MetaKor/MKV-Boards/Boards/IMD+IMD_Latch/IMD_LATCH/IMD_LATCH.kicad_pcb

## KiCad design Boards/IMD+IMD_Latch/IMD_LATCH/IMD_LATCH.kicad_pcb (2020-12-04)

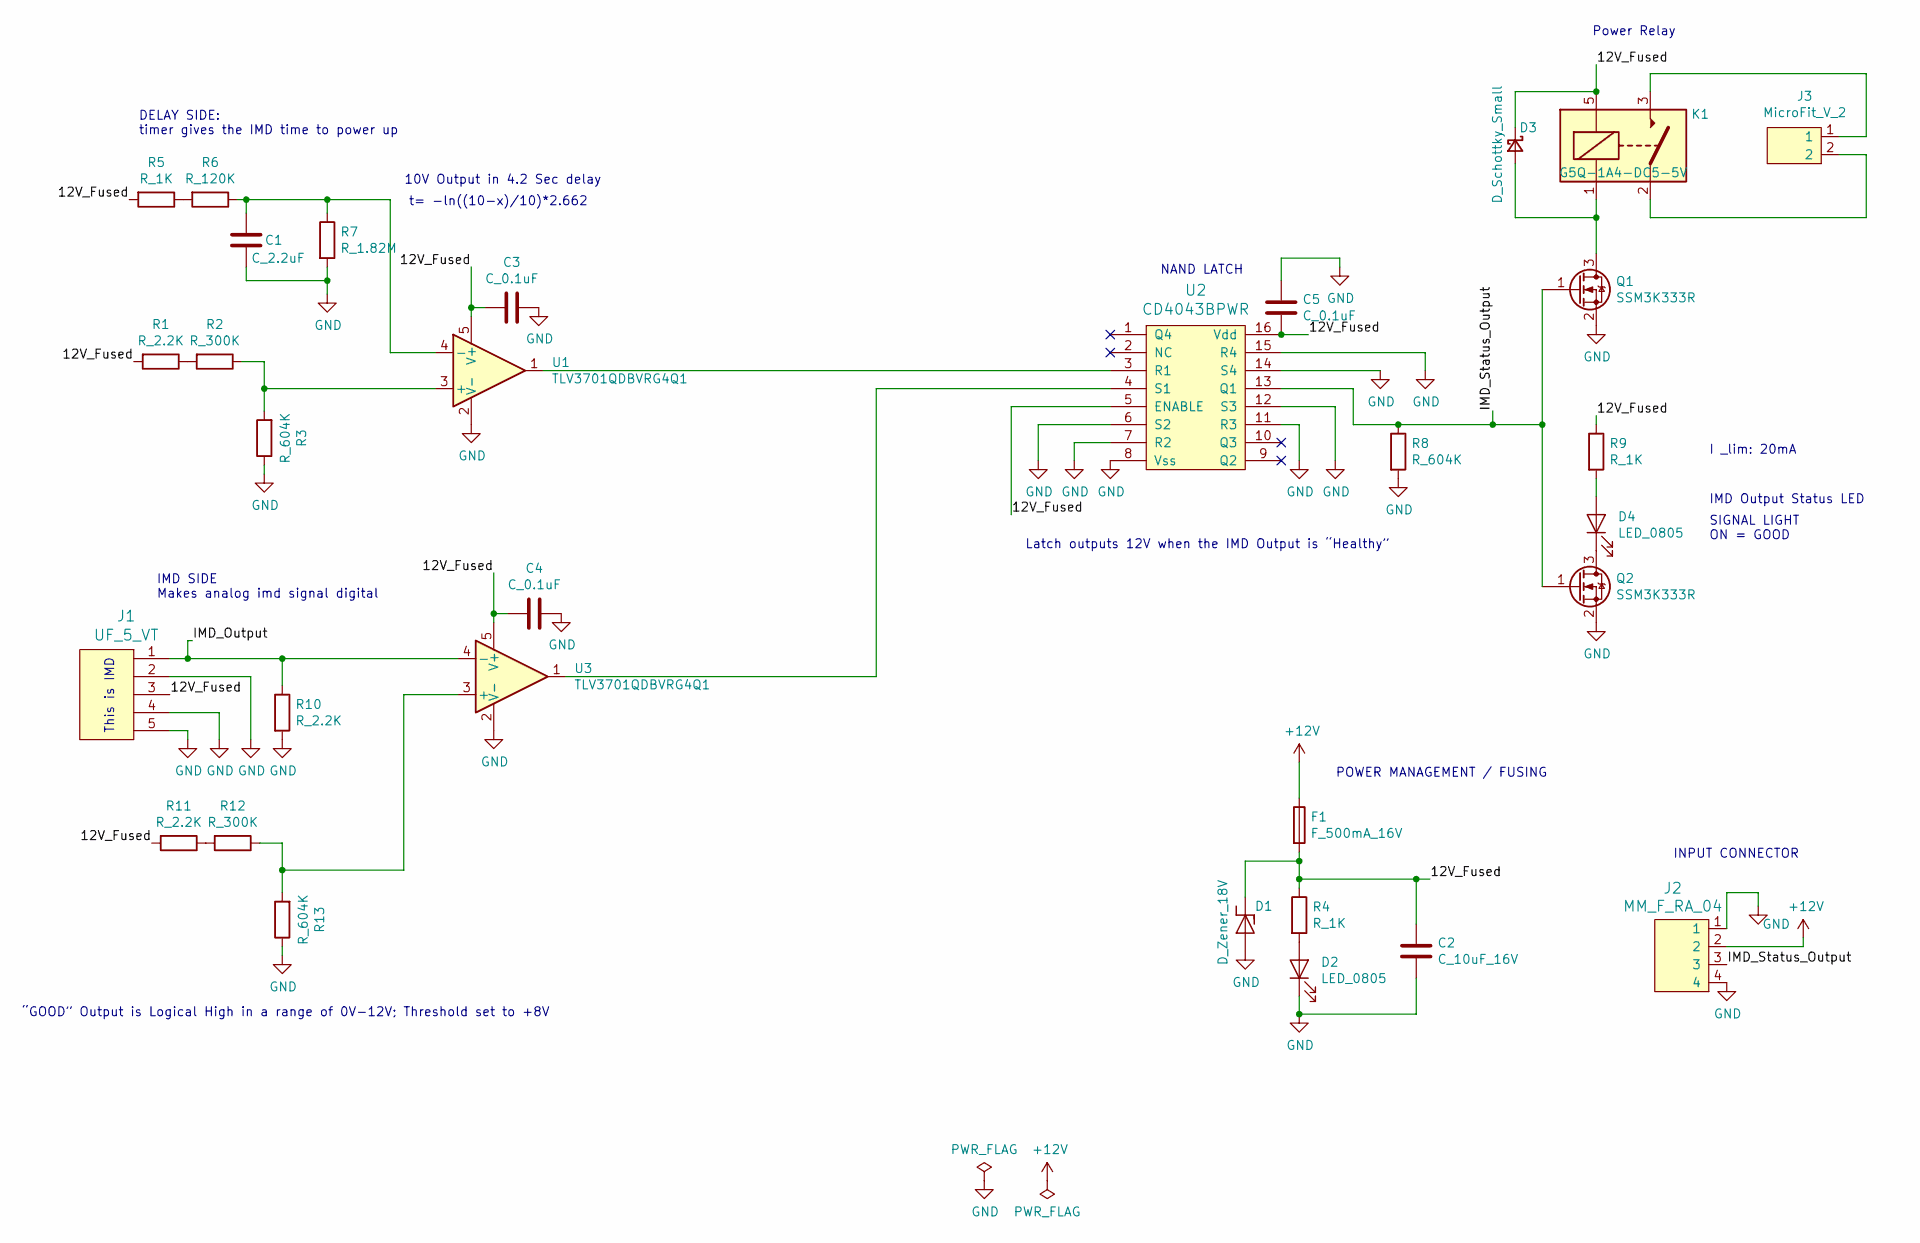
[picture p1: schematic IMD_LATCH.sch, IMD Latch]

Parts:
C1: C_2.2uF; C_0603_1608Metric; MPN 311-1451-1-ND
C2: C_10uF_16V; C_0805_OEM; MPN 1276-2399-1-ND
C3, C4, C5: C_0.1uF; C_0805_OEM; MPN 478-3352-1-ND
D1: D_Zener_18V; DO-214AA; MPN SMBJ5355B-TPMSCT-ND
D2, D4: LED_0805; LED_0805_OEM; MPN 475-1410-1-ND
D3: D_Schottky_Small; D_0805_OEM
F1: F_500mA_16V; Fuse_1210; MPN 507-1786-1-ND
J1: UF_5_VT; Ultrafit_5; MPN WM11667-ND
J2: MM_F_RA_04; micromatch_female_ra_4; MPN 338070-4
J3: MicroFit_V_2; MPN WM10660-ND
K1: G5Q-1A4-DC5-5V; Relay_SPST_OMRON-G5Q-1A4_OEM; MPN Z3632-ND
Q1, Q2: SSM3K333R; SOT-23F; MPN SSM3K333RLFCT-ND
R1, R10, R11: R_2.2K; R_0805_OEM; MPN RMCF0805FT2K20CT-ND
R2, R12: R_300K; R_0805_OEM; MPN P300KDACT-ND
R3, R8, R13: R_604K; R_0805_OEM; MPN RMCF0805FT604KCT-ND
R4, R5, R9: R_1K; R_0805_OEM; MPN RNCP0805FTD1K00CT-ND
R6: R_120K; R_0805_OEM; MPN RMCF0805FT120KCT-ND
R7: R_1.82M; R_0805_OEM; MPN RMCF0805FT1M82CT-ND
U1, U3: TLV3701QDBVRG4Q1; SOT-23-5_OEM; MPN 497-10249-1-ND
U2: CD4043BPWR; TSSOP-16-OEM; MPN 296-14106-1-ND

Connections:
+12V: F1.1, J2.2
/12V_Fused: C2.1, C3.2, C4.2, C5.2, D1.1 (K), D3.1 (K), F1.2, J1.3, K1.5, R1.2, R4.1, R5.2, R9.1, R11.2, U1.5 (V+), U2.5 (ENABLE), U2.16 (Vdd), U3.5 (V+)
/IMD_Output: J1.1, R10.1, U3.4 (-)
/IMD_Status_Output: J2.3, Q1.1 (G), Q2.1 (G), R8.1, U2.13 (Q1)
GND: C1.2, C2.2, C3.1, C4.1, C5.1, D1.2 (A), D2.1 (K), J1.2, J1.4, J1.5, J2.1, J2.4, Q1.2 (S), Q2.2 (S), R3.1, R7.2, R8.2, R10.2, R13.1, U1.2 (V-), U2.6 (S2), U2.7 (R2), U2.8 (Vss), U2.11 (R3), U2.12 (S3), U2.14 (S4), U2.15 (R4), U3.2 (V-)
unnamed: C1.1, R6.1, R7.1, U1.4 (-)
unnamed: D2.2 (A), R4.2
unnamed: D3.2 (A), K1.1, Q1.3 (D)
unnamed: D4.1 (K), Q2.3 (D)
unnamed: D4.2 (A), R9.2
unnamed: J3.1, K1.3
unnamed: J3.2, K1.2
unnamed: R1.1, R2.2
unnamed: R2.1, R3.2, U1.3 (+)
unnamed: R5.1, R6.2
unnamed: R11.1, R12.2
unnamed: R12.1, R13.2, U3.3 (+)
unnamed: U1.1, U2.3 (R1)
unnamed: U2.4 (S1), U3.1

Notes on the sheet:
IMD SIDE Makes analog imd signal digital
“GOOD” Output is Logical High in a range of 0V-12V; Threshold set to +8V
INPUT CONNECTOR
NAND LATCH
Power Relay
10V Output in 4.2 Sec delay
t= -ln((10-x)/10)*2.662
DELAY SIDE: timer gives the IMD time to power up
This is IMD
Latch outputs 12V when the IMD Output is “Healthy”
POWER MANAGEMENT / FUSING
SIGNAL LIGHT ON = GOOD
I _lim: 20mA
IMD Output Status LED

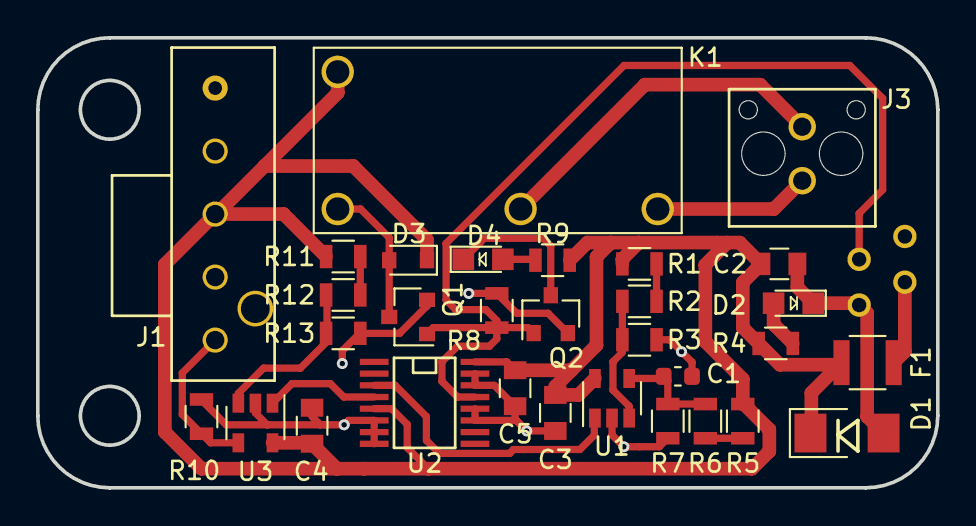
[picture p2: board IMD_LATCH.kicad_pcb from above]

Board: 2 copper layers, 50.0 x 25.0 mm, 32 parts (1 on the bottom side), 19 nets.
