MetaKor/MKV-Boards/(commit log)

2020-11-22 Primary detangling of IMD Latch layout ratsnest
    [IMD_LATCH.kicad_pcb]
2020-11-22 First draft of complete layout
    [IMD_LATCH.kicad_pcb]
2020-12-04 Layout revision with updated connector placement and back layer.
    [IMD_LATCH.kicad_pcb, IMD_LATCH.sch, IMD_LATCH_backup.kicad_pcb, IMD_LATCH_backup2.kicad_pcb]
